vanceb/ESP32_Clock/README.md

# ESP32_Clock
Clock based on the ESP32

A follow-on from the NightClock
