vanceb/ESP32_Clock/kicad/inkscape_dxf_export_options.png

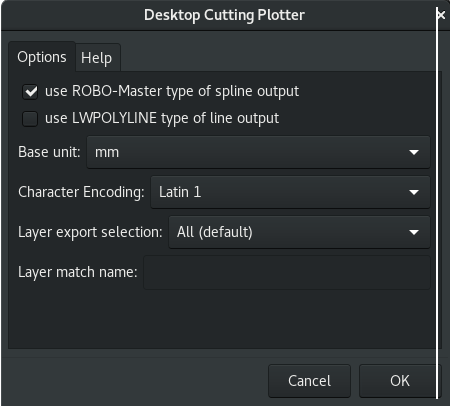
kicad/inkscape_dxf_export_options.png
