vanceb/ESP32_Clock/kicad/kicad_svg_export.png

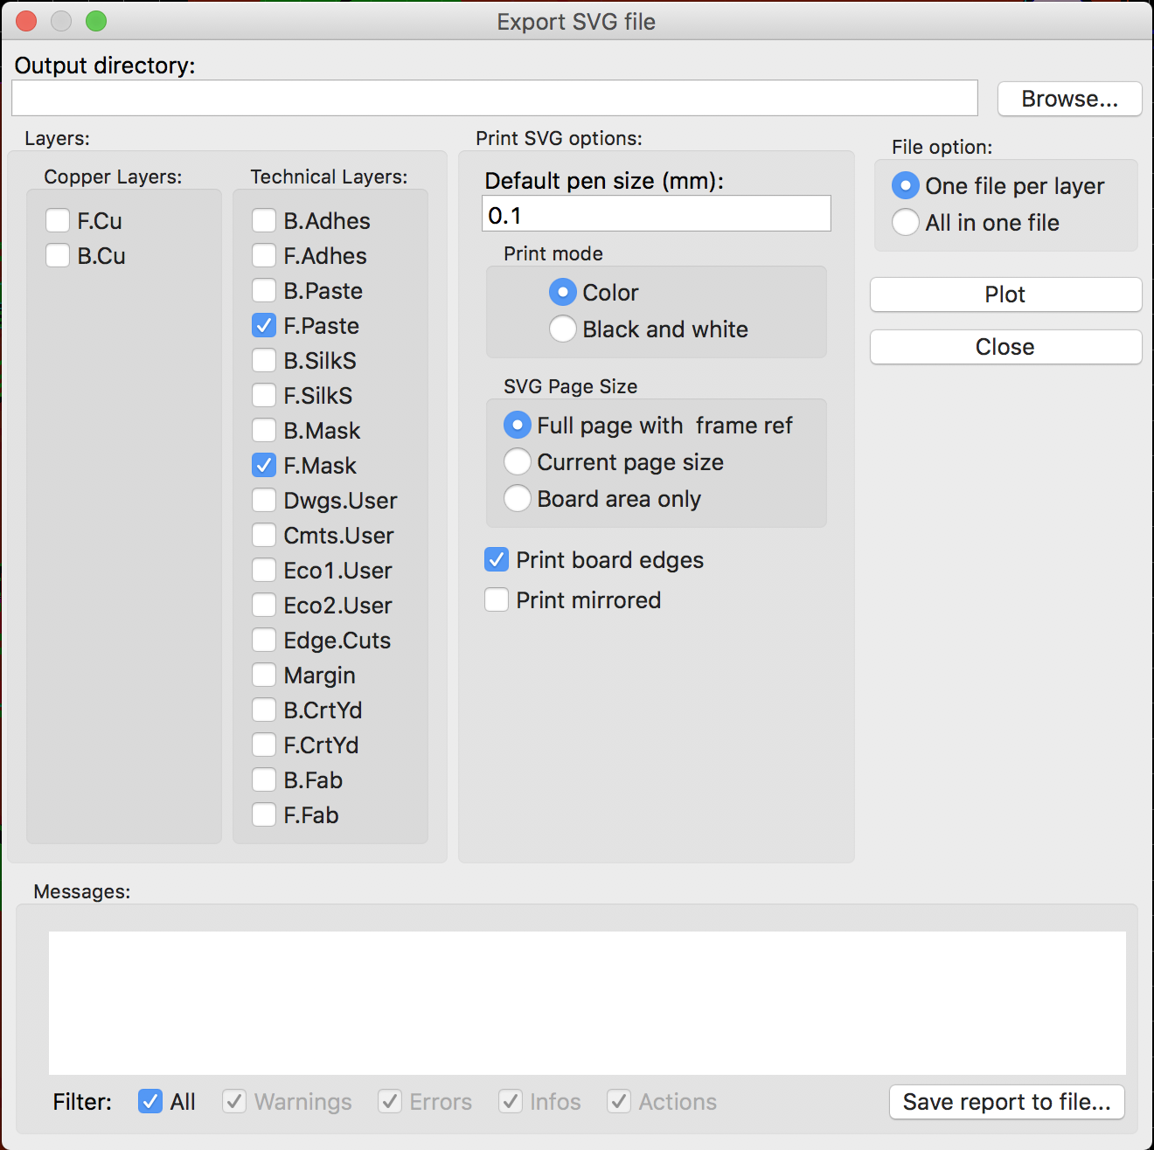
kicad/kicad_svg_export.png
