vanceb/ESP32_Clock/kicad/RDWorks.png

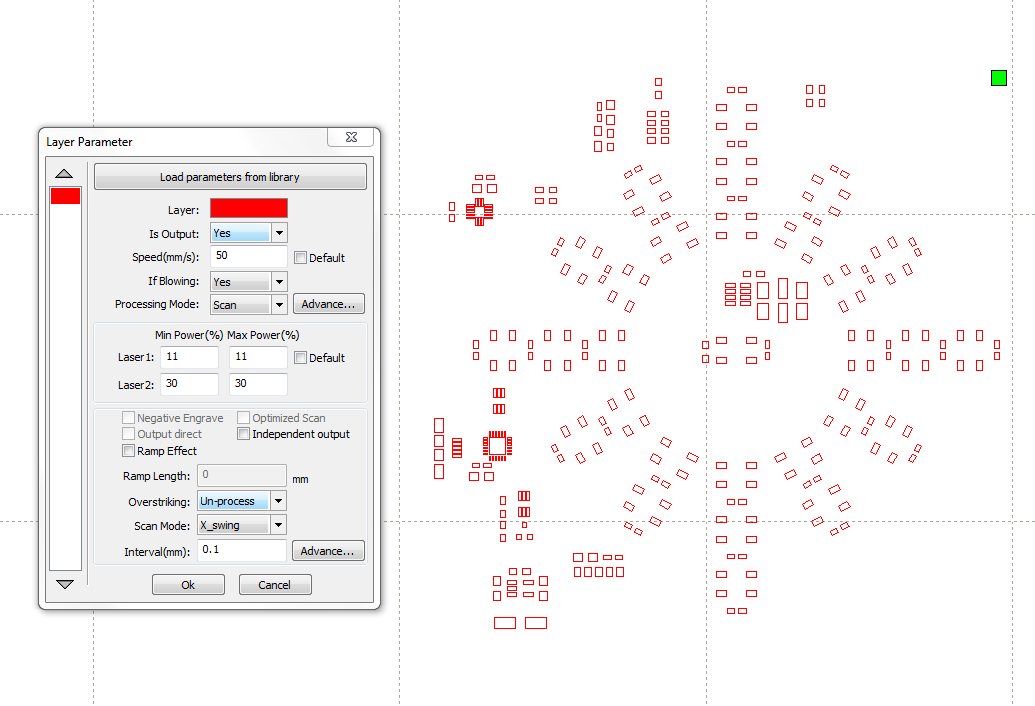
kicad/RDWorks.png
