vanceb/ESP32_Clock/code/components/wifi_manager/README

This component has been copied from https://github.com/tonyp7/esp32-wifi-manager
Changes have been made to integrate it with my project.
