vanceb/ESP32_Clock/kicad/ESP32_Clock_V2_BOM.ods

ESP32 Clock V2.0 BOM
Item | Qty | Reference(s) | Value
1 | 2 | C1, C8 | 100nF
2 | 2 | C2, C7 | 10uF
3 | 1 | C3 | CP
4 | 2 | C4, C5 | 4.7uF
5 | 1 | C6 | 1uF
6 | 29 | C9, C10, C11, C12, C13, C14, C15, C16, C17, C18, C19, C20, C21, C22, C23, C24, C25, C26, C27, C28, C29, C30, C31, C32, C33, C34, C35, C36, C37 | 0.1uF
7 | 2 | C38, C40 | 1uF
8 | 1 | C39 | 47uF
9 | 1 | D1
10 | 2 | D2, D3 | LED
11 | 1 | J1 | Pwr
12 | 1 | J2 | Battery
13 | 1 | J3 | FTDI
14 | 1 | J4 | LEDs
15 | 1 | J9 | Gesture
16 | 1 | J10 | OLED
17 | 1 | J11 | MMA8542Q Accelerometer
18 | 1 | R1 | 2k
19 | 8 | R2, R3, R4, R5, R11, R12, R14, R15 | 4k7
20 | 3 | R6, R10, R16 | 10k
21 | 2 | R7, R8 | 1k
22 | 1 | R9 | 100R
23 | 1 | R13 | 22R
24 | 1 | SW1 | Reset
25 | 1 | SW2 | Program
26 | 1 | U1 | MCP73831
27 | 1 | U2 | BA33DD0WHFP
28 | 1 | U3 | ESP32-WROOM
29 | 29 | U4, U5, U6, U7, U8, U9, U10, U11, U12, U13, U14, U15, U16, U17, U18, U19, U20, U21, U22, U23, U24, U25, U26, U27, U28, U29, U30, U31, U32 | WS2812B
30 | 1 | U33 | APDS-9960
