vanceb/ESP32_Clock/kicad/bom.ods

Collated Components:
Item | Qty | Reference(s) | Value | Footprint
1 | 3 | C1, C2, C42 | 4.7uF | Capacitors_SMD:C_0805_HandSoldering
2 | 1 | C3 | 1uF | Capacitors_SMD:C_0805_HandSoldering
3 | 3 | C4, C7, C9 | 100nF | Capacitors_SMD:C_0603_HandSoldering
4 | 3 | C5, C6, C8 | 10uF | Capacitors_SMD:C_0805_HandSoldering
5 | 31 | C10, C11, C12, C13, C14, C15, C16, C17, C18, C19, C20, C21, C22, C23, C24, C25, C26, C27, C28, C29, C30, C31, C32, C33, C34, C35, C36, C37, C38, C43, C44 | 0.1uF | Capacitors_SMD:C_0603_HandSoldering
6 | 2 | C39, C41 | 1uF | Capacitors_Tantalum_SMD:CP_Tantalum_Case-R_EIA-2012-12_Hand
7 | 1 | C40 | 47uF | Capacitors_Tantalum_SMD:CP_Tantalum_Case-A_EIA-3216-18_Hand
8 | 1 | C45 | CP | Capacitors_THT:CP_Radial_D8.0mm_P3.50mm
9 | 2 | D1, D2 | LED | LEDs:LED_0603_HandSoldering
10 | 1 | D3 |  | Diodes_SMD:D_SMA_Handsoldering
11 | 1 | J1 | Battery | Connectors_JST:JST_PH_S2B-PH-K_02x2.00mm_Angled
12 | 1 | J2 | LEDs | Pin_Headers:Pin_Header_Straight_1x03_Pitch2.54mm
13 | 1 | J3 | PWR | Pin_Headers:Pin_Header_Straight_1x04_Pitch2.54mm
14 | 1 | J4 | Grove 1 | Pin_Headers:Pin_Header_Straight_1x04_Pitch2.54mm
15 | 1 | J5 | Grove 2 | Pin_Headers:Pin_Header_Straight_1x04_Pitch2.54mm
16 | 1 | J6 | Grove 3 | Pin_Headers:Pin_Header_Straight_1x04_Pitch2.54mm
17 | 1 | J7 | Grove 4 | Pin_Headers:Pin_Header_Straight_1x04_Pitch2.54mm
18 | 1 | J8 | USB_OTG | MicroUSB_Custom:MicroUSB
19 | 1 | J9 | Gesture | Pin_Headers:Pin_Header_Straight_1x05_Pitch2.54mm
20 | 1 | J10 | OLED | 128x32_OLED:128x32_OLED
21 | 1 | J12 | FTDI | Pin_Headers:Pin_Header_Straight_1x06_Pitch2.54mm
22 | 1 | Q1 | NXP2301P | TO_SOT_Packages_SMD:SOT-23
23 | 1 | Q2 | BCM857 | TO_SOT_Packages_SMD:SOT-363_SC-70-6_Handsoldering
24 | 1 | Q3 | UMH3N | TO_SOT_Packages_SMD:SOT-363_SC-70-6_Handsoldering
25 | 3 | R1, R3, R11 | 10k | Resistors_SMD:R_0603_HandSoldering
26 | 1 | R2 | 2k | Resistors_SMD:R_0603_HandSoldering
27 | 1 | R4 | 47k | Resistors_SMD:R_0603_HandSoldering
28 | 8 | R5, R6, R7, R8, R12, R13, R15, R16 | 4k7 | Resistors_SMD:R_0603_HandSoldering
29 | 2 | R9, R10 | 1k | Resistors_SMD:R_0603_HandSoldering
30 | 1 | R14 | 22R | Resistors_SMD:R_0603_HandSoldering
31 | 1 | R17 | 100R | Resistors_SMD:R_0603_HandSoldering
32 | 1 | SW1 | Reset | Buttons_Switches_SMD:SW_SPST_EVPBF
33 | 1 | SW2 | Program | Buttons_Switches_SMD:SW_SPST_EVPBF
34 | 1 | U1 | MCP73831 | TO_SOT_Packages_SMD:SOT-23-5_HandSoldering
35 | 1 | U2 | ESP32-WROOM | ESP32-footprints-Lib:ESP32-WROOM
36 | 1 | U3 | BA33DD0WHFP | LDO:LDO
37 | 1 | U4 | CP2104 | QFN-24:QFN-24
38 | 29 | U5, U6, U7, U8, U9, U10, U11, U12, U13, U14, U15, U16, U17, U18, U19, U20, U21, U22, U23, U24, U25, U26, U27, U28, U29, U30, U31, U32, U33 | WS2812B | LEDs:LED_WS2812B-PLCC4
39 | 1 | U34 | APDS-9960 | ADPS-9960:ADPS-9960
40 | 1 | U35 | MMA8452Q | QFN16:QFN-16
