vanceb/ESP32_Clock/kicad/ESP32_Clock.kicad_pcb

## KiCad design kicad/ESP32_Clock.kicad_pcb (2018-07-30)

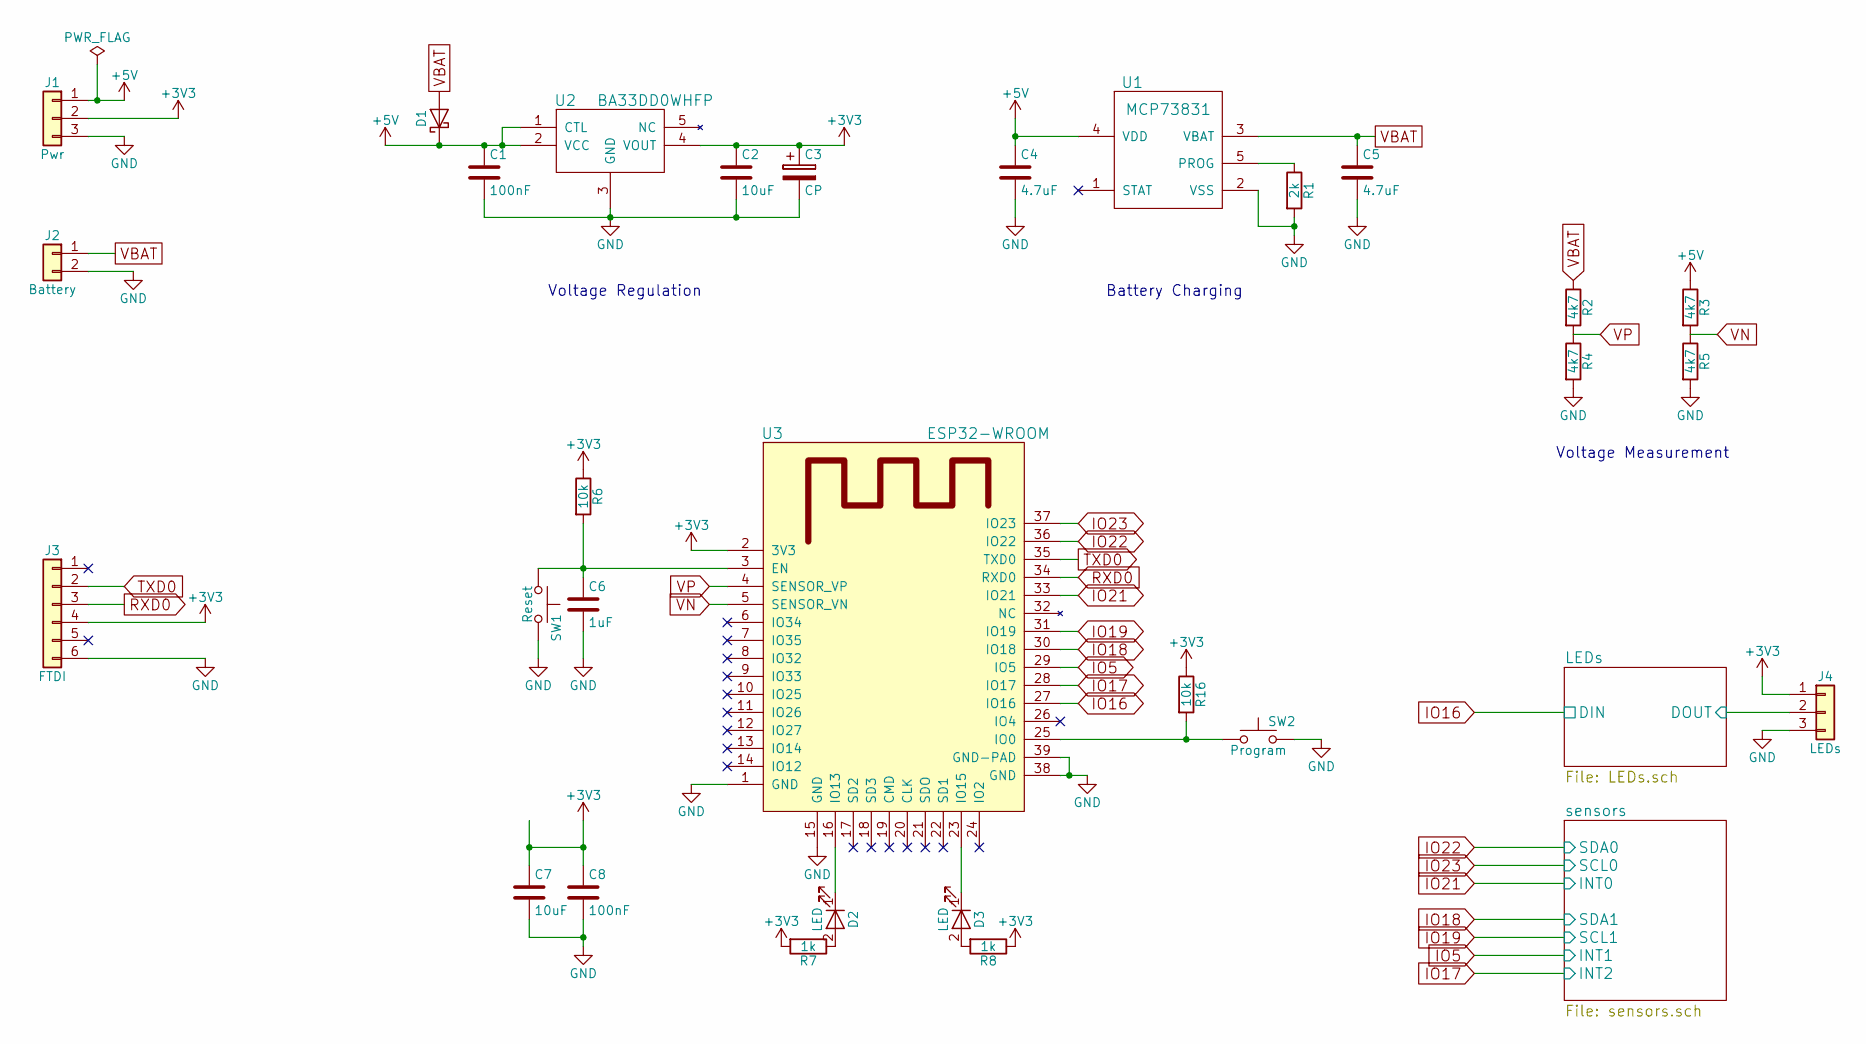
[picture p4: schematic ESP32_Clock-2018-08-15-16-18-59.sch]

Parts:
C1, C8: 100nF; C_0603_HandSoldering
C2, C7: 10uF; C_0805_HandSoldering
C3: CP; CP_Radial_D8.0mm_P3.50mm
C4, C5: 4.7uF; C_0805_HandSoldering
C6: 1uF; C_0805_HandSoldering
D1: D_SMA_Handsoldering
D2, D3: LED; LED_0603_HandSoldering
J1: Pwr; Pin_Header_Straight_1x03_Pitch2.54mm
J2: Battery; JST_PH_S2B-PH-K_02x2.00mm_Angled
J3: FTDI; Pin_Header_Straight_1x06_Pitch2.54mm
J4: LEDs; Pin_Header_Straight_1x03_Pitch2.54mm
R1: 2k; R_0603_HandSoldering
R2, R3, R4, R5: 4k7; R_0603_HandSoldering
R6, R16: 10k; R_0603_HandSoldering
R7, R8: 1k; R_0603_HandSoldering
SW1: Reset; SW_SPST_EVPBF
SW2: Program; SW_SPST_EVPBF
U1: MCP73831; SOT-23-5_HandSoldering
U2: BA33DD0WHFP; LDO
U3: ESP32-WROOM

Connections:
+3V3: C2.1, C3.1, C7.1, C8.1, J1.2, J3.4, J4.1, R6.1, R7.2, R8.1, R16.1, U2.4 (VOUT), U3.2 (3V3); also elsewhere on the board
+5V: C1.1, C4.1, D1.1 (K), J1.1, R3.1, U1.4 (VDD), U2.1 (CTL), U2.2 (VCC)
/LEDs/DOUT: J4.2; also elsewhere on the board
GND: C1.2, C2.2, C3.2, C4.2, C5.2, C6.2, C7.2, C8.2, J1.3, J2.2, J3.6, J4.3, R1.2, R4.2, R5.2, SW1.2, SW2.2, U1.2 (VSS), U2.3 (GND), U3.1 (GND), U3.15 (GND), U3.38 (GND), U3.39 (GND-PAD); also elsewhere on the board
IO5: U3.29 (IO5); also elsewhere on the board
IO16: U3.27 (IO16); also elsewhere on the board
IO17: U3.28 (IO17); also elsewhere on the board
IO18: U3.30 (IO18); also elsewhere on the board
IO19: U3.31 (IO19); also elsewhere on the board
IO21: U3.33 (IO21); also elsewhere on the board
IO22: U3.36 (IO22); also elsewhere on the board
IO23: U3.37 (IO23); also elsewhere on the board
unnamed: C6.1, R6.2, SW1.1, U3.3 (EN)
unnamed: D2.1 (K), U3.16 (IO13)
unnamed: D2.2 (A), R7.1
unnamed: D3.1 (K), U3.23 (IO15)
unnamed: D3.2 (A), R8.2
unnamed: R1.1, U1.5 (PROG)
unnamed: R16.2, SW2.1, U3.25 (IO0)
RXD0: J3.3, U3.34 (RXD0)
TXD0: J3.2, U3.35 (TXD0)
VBAT: C5.1, D1.2 (A), J2.1, R2.1, U1.3 (VBAT)
VN: R3.2, R5.1, U3.5 (SENSOR_VN)
VP: R2.2, R4.1, U3.4 (SENSOR_VP)

Notes on the sheet:
Voltage Regulation
Battery Charging
Voltage Measurement

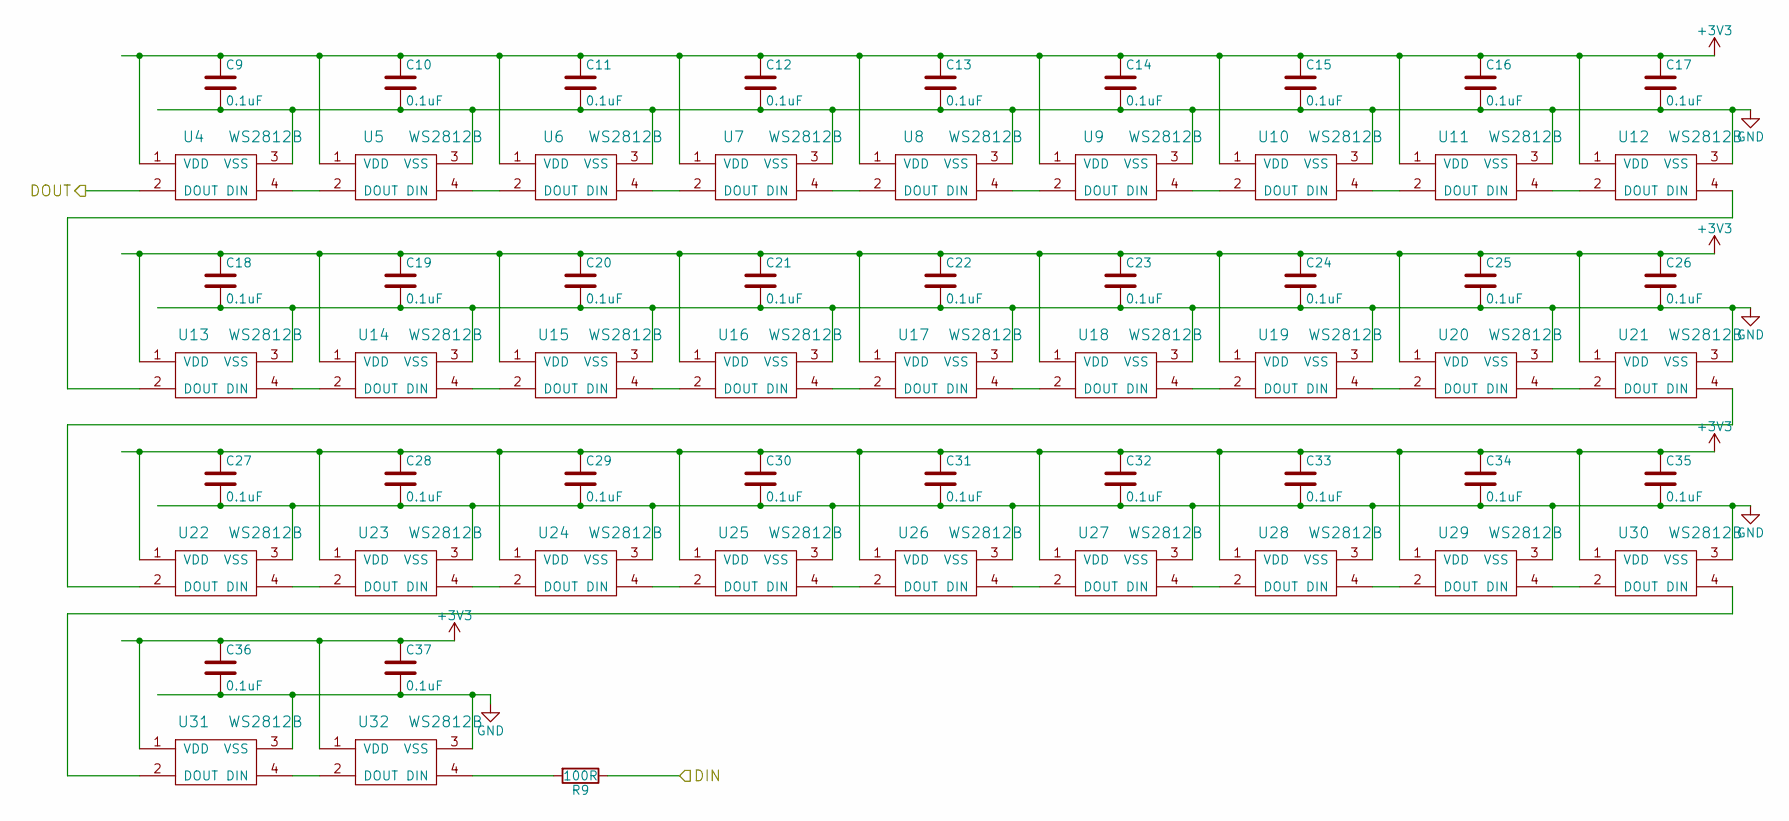
[picture p5: schematic LEDs-2018-08-15-16-18-59.sch]

Parts:
C9, C10, C11, C12, C13, C14, C15, C16, C17, C18, C19, C20, C21, C22, C23, C24, C25, C26, C27, C28, C29, C30, C31, C32, C33, C34, C35, C36, C37: 0.1uF; C_0603_HandSoldering
R9: 100R; R_0603_HandSoldering
U4, U5, U6, U7, U8, U9, U10, U11, U12, U13, U14, U15, U16, U17, U18, U19, U20, U21, U22, U23, U24, U25, U26, U27, U28, U29, U30, U31, U32: WS2812B; LED_WS2812B-PLCC4

Connections:
+3V3: C9.1, C10.1, C11.1, C12.1, C13.1, C14.1, C15.1, C16.1, C17.1, C18.1, C19.1, C20.1, C21.1, C22.1, C23.1, C24.1, C25.1, C26.1, C27.1, C28.1, C29.1, C30.1, C31.1, C32.1, C33.1, C34.1, C35.1, C36.1, C37.1, U4.1 (VDD), U5.1 (VDD), U6.1 (VDD), U7.1 (VDD), U8.1 (VDD), U9.1 (VDD), U10.1 (VDD), U11.1 (VDD), U12.1 (VDD), U13.1 (VDD), U14.1 (VDD), U15.1 (VDD), U16.1 (VDD), U17.1 (VDD), U18.1 (VDD), U19.1 (VDD), U20.1 (VDD), U21.1 (VDD), U22.1 (VDD), U23.1 (VDD), U24.1 (VDD), U25.1 (VDD), U26.1 (VDD), U27.1 (VDD), U28.1 (VDD), U29.1 (VDD), U30.1 (VDD), U31.1 (VDD), U32.1 (VDD); also elsewhere on the board
/LEDs/DOUT: U4.2 (DOUT); also elsewhere on the board
GND: C9.2, C10.2, C11.2, C12.2, C13.2, C14.2, C15.2, C16.2, C17.2, C18.2, C19.2, C20.2, C21.2, C22.2, C23.2, C24.2, C25.2, C26.2, C27.2, C28.2, C29.2, C30.2, C31.2, C32.2, C33.2, C34.2, C35.2, C36.2, C37.2, U4.3 (VSS), U5.3 (VSS), U6.3 (VSS), U7.3 (VSS), U8.3 (VSS), U9.3 (VSS), U10.3 (VSS), U11.3 (VSS), U12.3 (VSS), U13.3 (VSS), U14.3 (VSS), U15.3 (VSS), U16.3 (VSS), U17.3 (VSS), U18.3 (VSS), U19.3 (VSS), U20.3 (VSS), U21.3 (VSS), U22.3 (VSS), U23.3 (VSS), U24.3 (VSS), U25.3 (VSS), U26.3 (VSS), U27.3 (VSS), U28.3 (VSS), U29.3 (VSS), U30.3 (VSS), U31.3 (VSS), U32.3 (VSS); also elsewhere on the board
IO16: R9.1; also elsewhere on the board
unnamed: R9.2, U32.4 (DIN)
unnamed: U4.4 (DIN), U5.2 (DOUT)
unnamed: U5.4 (DIN), U6.2 (DOUT)
unnamed: U6.4 (DIN), U7.2 (DOUT)
unnamed: U7.4 (DIN), U8.2 (DOUT)
unnamed: U8.4 (DIN), U9.2 (DOUT)
unnamed: U9.4 (DIN), U10.2 (DOUT)
unnamed: U10.4 (DIN), U11.2 (DOUT)
unnamed: U11.4 (DIN), U12.2 (DOUT)
unnamed: U12.4 (DIN), U13.2 (DOUT)
unnamed: U13.4 (DIN), U14.2 (DOUT)
unnamed: U14.4 (DIN), U15.2 (DOUT)
unnamed: U15.4 (DIN), U16.2 (DOUT)
unnamed: U16.4 (DIN), U17.2 (DOUT)
unnamed: U17.4 (DIN), U18.2 (DOUT)
unnamed: U18.4 (DIN), U19.2 (DOUT)
unnamed: U19.4 (DIN), U20.2 (DOUT)
unnamed: U20.4 (DIN), U21.2 (DOUT)
unnamed: U21.4 (DIN), U22.2 (DOUT)
unnamed: U22.4 (DIN), U23.2 (DOUT)
unnamed: U23.4 (DIN), U24.2 (DOUT)
unnamed: U24.4 (DIN), U25.2 (DOUT)
unnamed: U25.4 (DIN), U26.2 (DOUT)
unnamed: U26.4 (DIN), U27.2 (DOUT)
unnamed: U27.4 (DIN), U28.2 (DOUT)
unnamed: U28.4 (DIN), U29.2 (DOUT)
unnamed: U29.4 (DIN), U30.2 (DOUT)
unnamed: U30.4 (DIN), U31.2 (DOUT)
unnamed: U31.4 (DIN), U32.2 (DOUT)

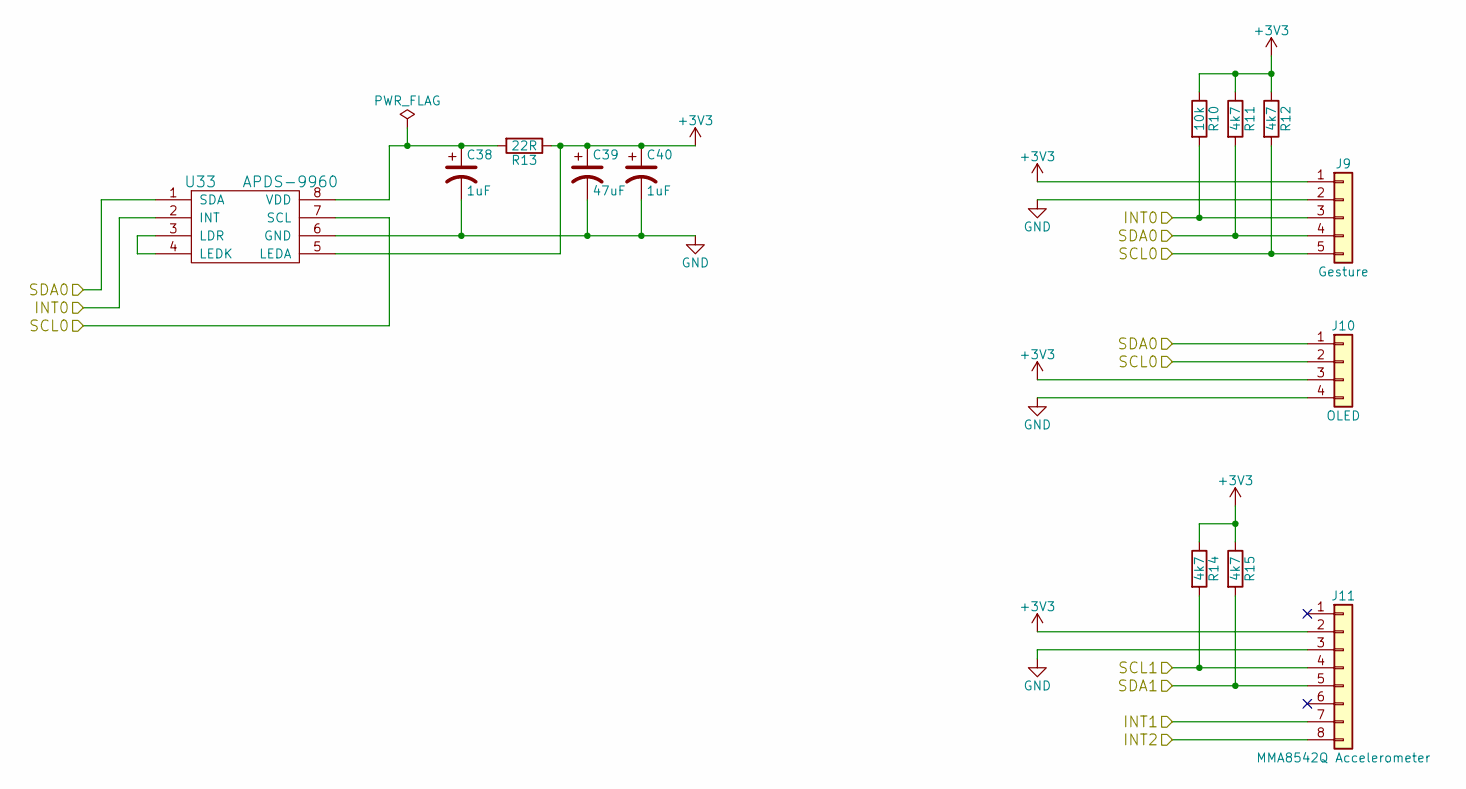
[picture p6: schematic sensors-2018-08-15-16-18-59.sch]

Parts:
C38, C40: 1uF; CP_Tantalum_Case-R_EIA-2012-12_Hand
C39: 47uF; CP_Tantalum_Case-A_EIA-3216-18_Hand
J9: Gesture; Pin_Header_Straight_1x05_Pitch2.54mm
J10: OLED; 128x32_OLED
J11: MMA8542Q Accelerometer; Pin_Header_Straight_1x08_Pitch2.54mm
R10: 10k; R_0603_HandSoldering
R11, R12, R14, R15: 4k7; R_0603_HandSoldering
R13: 22R; R_0603_HandSoldering
U33: APDS-9960; ADPS-9960

Connections:
+3V3: C39.1, C40.1, J9.1, J10.3, J11.2, R10.1, R11.1, R12.1, R13.1, R14.1, R15.1, U33.5 (LEDA); also elsewhere on the board
GND: C38.2, C39.2, C40.2, J9.2, J10.4, J11.3, U33.6 (GND); also elsewhere on the board
IO5: J11.7; also elsewhere on the board
IO17: J11.8; also elsewhere on the board
IO18: J11.5, R15.2; also elsewhere on the board
IO19: J11.4, R14.2; also elsewhere on the board
IO21: J9.3, R10.2, U33.2 (INT); also elsewhere on the board
IO22: J9.4, J10.1, R11.2, U33.1 (SDA); also elsewhere on the board
IO23: J9.5, J10.2, R12.2, U33.7 (SCL); also elsewhere on the board
unnamed: C38.1, R13.2, U33.8 (VDD)
unnamed: U33.3 (LDR), U33.4 (LEDK)

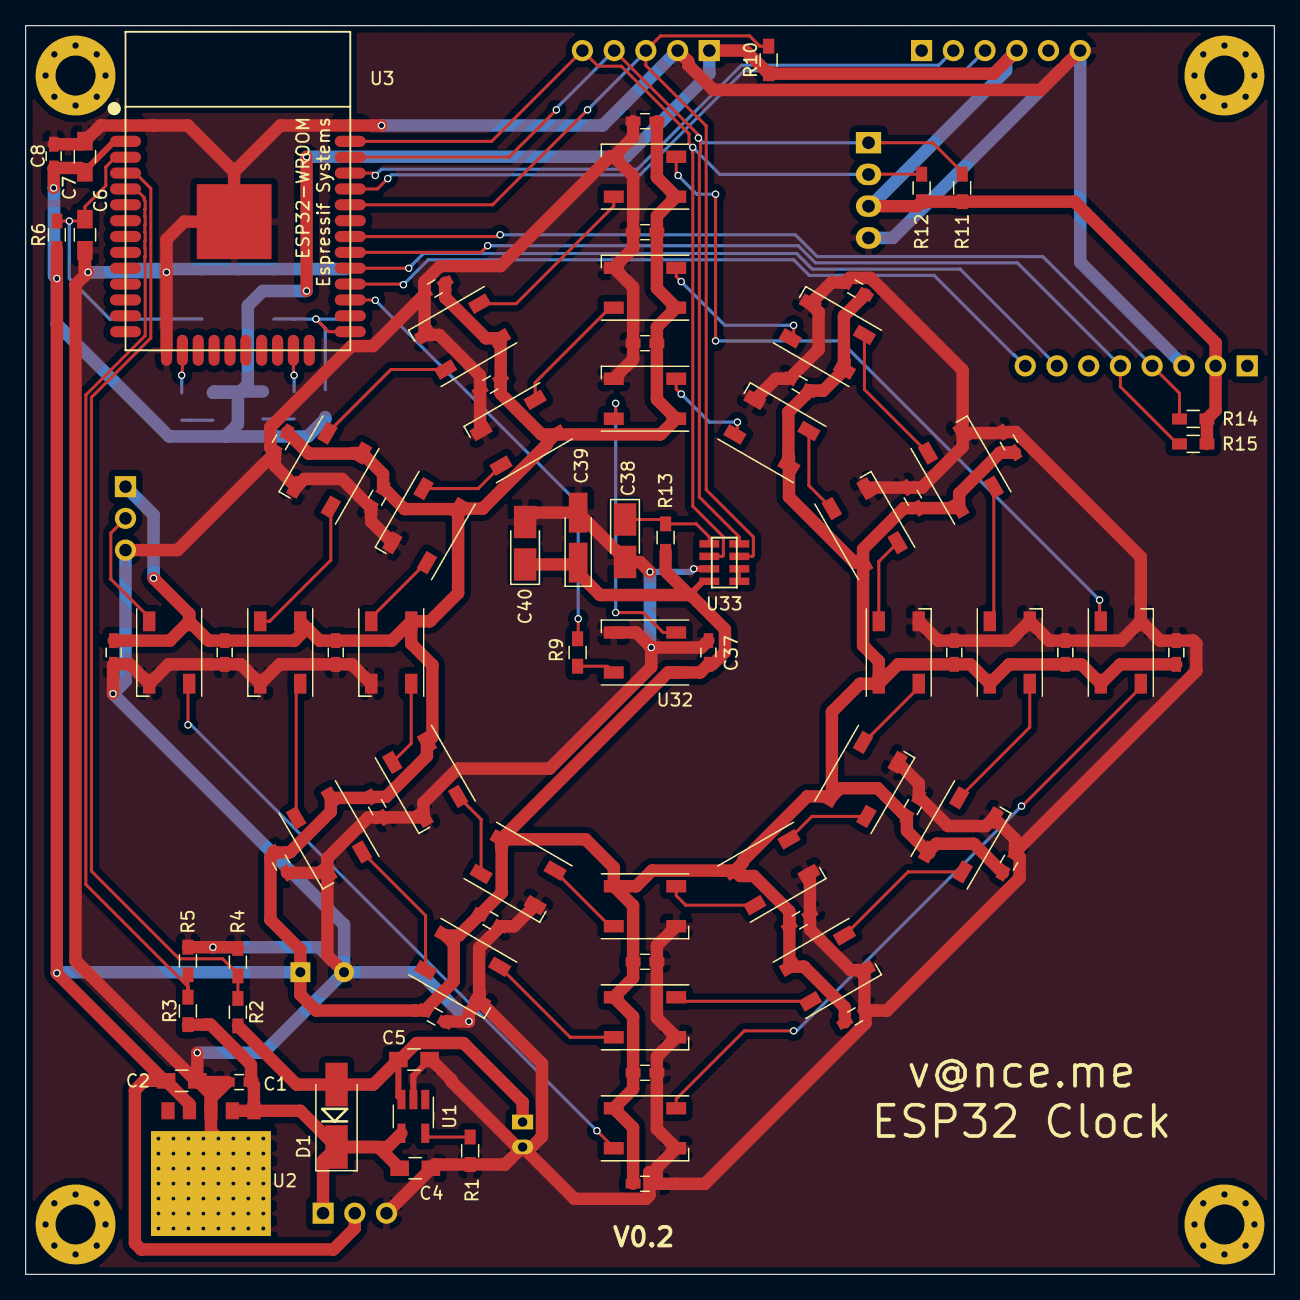
[picture p7: board ESP32_Clock.kicad_pcb from above]

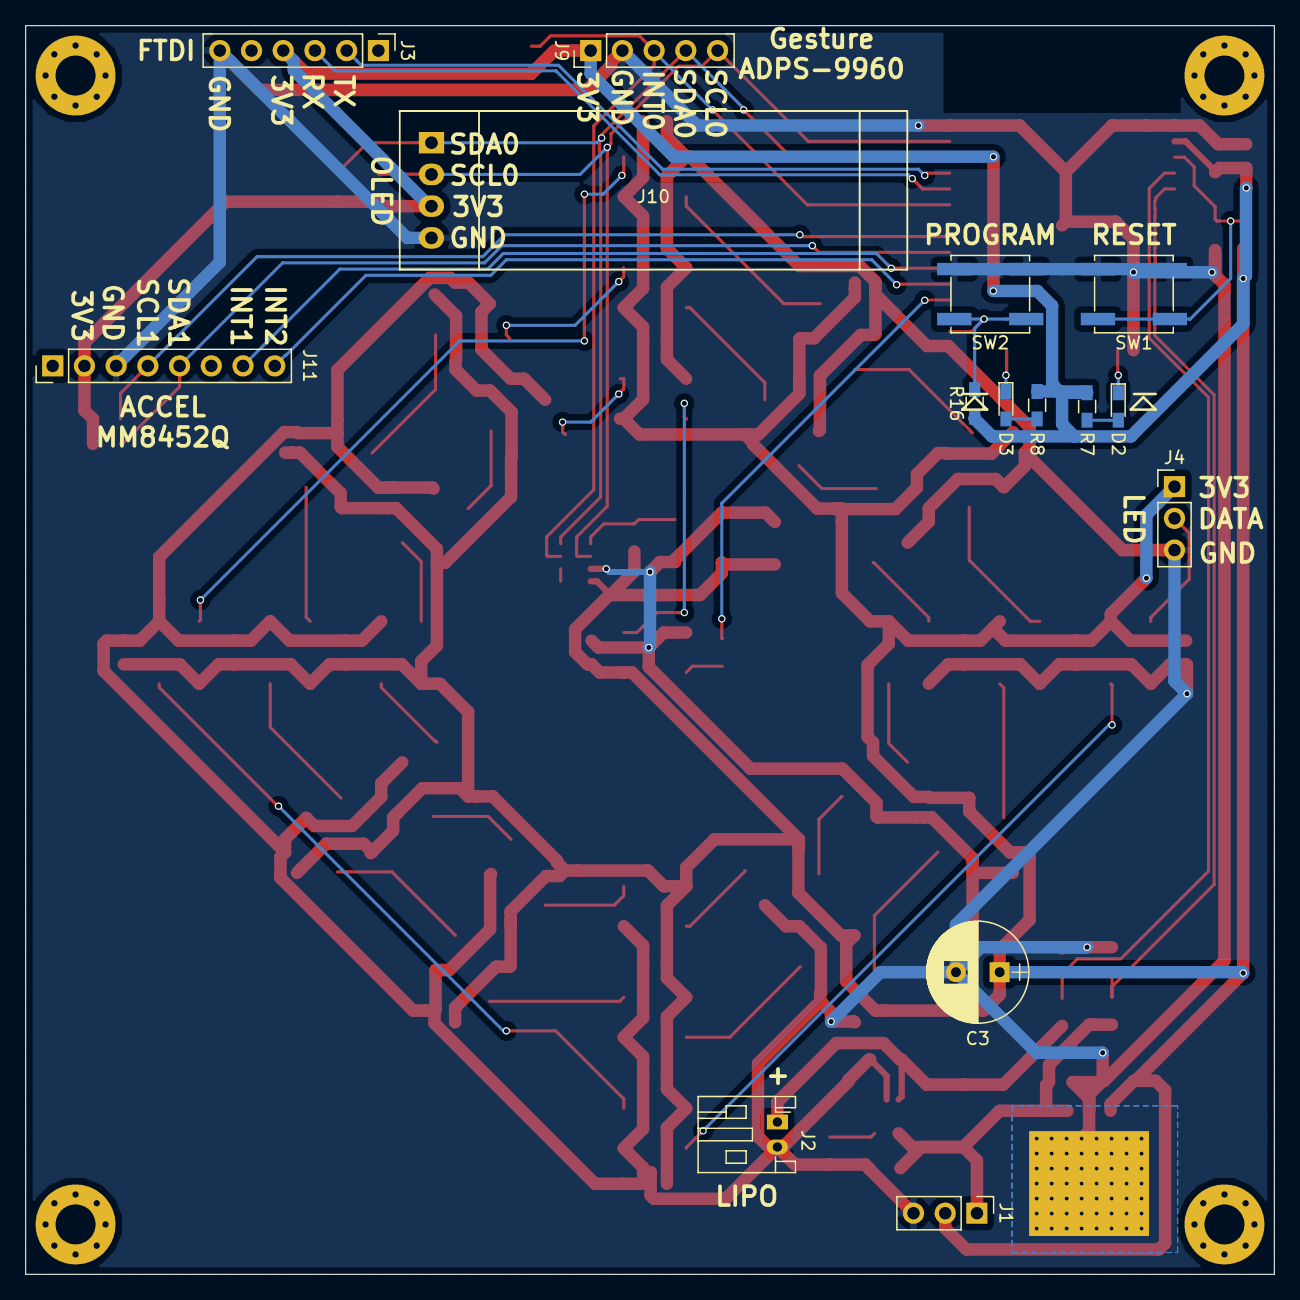
[picture p8: board ESP32_Clock.kicad_pcb from below]

Board: 2 copper layers, 100.0 x 100.0 mm, 101 parts (15 on the bottom side), 55 nets.
