vanceb/ESP32_Clock/code/main/main.c

/*
 * Copyright 2010-2015 Amazon.com, Inc. or its affiliates. All Rights Reserved.
 * Additions Copyright 2016 Espressif Systems (Shanghai) PTE LTD
 *
 * Licensed under the Apache License, Version 2.0 (the "License").
 * You may not use this file except in compliance with the License.
 * A copy of the License is located at
 *
 *  http://aws.amazon.com/apache2.0
 *
 * or in the "license" file accompanying this file. This file is distributed
 * on an "AS IS" BASIS, WITHOUT WARRANTIES OR CONDITIONS OF ANY KIND, either
 * express or implied. See the License for the specific language governing
 * permissions and limitations under the License.
 */
/**
 * @file subscribe_publish_sample.c
 * @brief simple MQTT publish and subscribe on the same topic
 *
 * This example takes the parameters from the build configuration and establishes a connection to the AWS IoT MQTT Platform.
 * It subscribes and publishes to the same topic - "test_topic/esp32"
 *
 * Some setup is required. See example README for details.
 *
 */
#include <stdio.h>
#include <stdlib.h>
#include <ctype.h>
#include <unistd.h>
#include <limits.h>
#include <string.h>
#include <math.h>

#include <time.h>
#include <sys/time.h>
#include "lwip/apps/sntp.h"

#include "freertos/FreeRTOS.h"
#include "freertos/task.h"
#include "freertos/event_groups.h"
#include "esp_system.h"
#include "esp_wifi.h"
#include "esp_event_loop.h"
#include "esp_log.h"
#include "esp_vfs_fat.h"
#include "driver/sdmmc_host.h"
#include "driver/gpio.h"
#include "driver/i2c.h"

#include "nvs.h"
#include "nvs_flash.h"

/* Needed for wifimanager */
#include "http_svr.h"
#include "wifi_manager.h"

// Project local code
#include "main.h"
//#include "clock_control.h"
#include "telemetry.h"
#include "clock_display.h"
#include "gesture.h"

#include "secrets.h"

static const char *TAG = "esp32clock";

static TaskHandle_t task_http_server = NULL;
static TaskHandle_t task_wifi_manager = NULL;

// Arduino-like functions to ease readability
uint32_t IRAM_ATTR millis()
{
  return xTaskGetTickCount() * portTICK_PERIOD_MS;
}

void delay(uint32_t ms)
{
  if (ms > 0) {
    vTaskDelay(ms / portTICK_PERIOD_MS);
  }
}

void i2cscanner(int sda_pin, int scl_pin) {
    static char tag[] = "i2cscanner";
	ESP_LOGD(tag, ">> i2cScanner");
    /* Set pins as outputs */
    if (i2c_set_pin(I2C_NUM_0, sda_pin, scl_pin, GPIO_PULLUP_DISABLE, GPIO_PULLUP_DISABLE, I2C_MODE_MASTER) != ESP_OK) {
        ESP_LOGE(TAG, "I2C GPIO pin configuration error");
    }

    /* Set up I2C configuration */
	i2c_config_t conf;
	conf.mode = I2C_MODE_MASTER;
	conf.sda_io_num = sda_pin;
	conf.scl_io_num = scl_pin;
	conf.sda_pullup_en = GPIO_PULLUP_DISABLE;
	conf.scl_pullup_en = GPIO_PULLUP_DISABLE;
	conf.master.clk_speed = 100000;
    /* Set configuration */
	if (i2c_param_config(I2C_NUM_0, &conf) != ESP_OK) {
        ESP_LOGE(TAG, "I2C configuration failed");
    }
    /* Install I2C driver */
	if (i2c_driver_install(I2C_NUM_0, I2C_MODE_MASTER, 0, 0, 0) != ESP_OK) {
        ESP_LOGE(TAG, "I2C driver install failed");
    }

	int i;
	esp_err_t espRc;
	printf("     0  1  2  3  4  5  6  7  8  9  a  b  c  d  e  f\n");
	printf("00:         ");
	for (i=3; i< 0x78; i++) {
		i2c_cmd_handle_t cmd = i2c_cmd_link_create();
		i2c_master_start(cmd);
		i2c_master_write_byte(cmd, (i << 1) | I2C_MASTER_WRITE, 1 /* expect ack */);
		i2c_master_stop(cmd);

		espRc = i2c_master_cmd_begin(I2C_NUM_0, cmd, 10/portTICK_PERIOD_MS);
		if (i%16 == 0) {
			printf("\n%.2x:", i);
		}
		if (espRc == 0) {
			printf(" %.2x", i);
		} else {
			printf(" --");
		}
		//ESP_LOGD(tag, "i=%d, rc=%d (0x%x)", i, espRc, espRc);
		i2c_cmd_link_delete(cmd);
	}
	printf("\n");
}

static void initialize_sntp(void)
{
    ESP_LOGI(TAG, "Initializing SNTP");
    sntp_setoperatingmode(SNTP_OPMODE_POLL);
    sntp_setservername(0, "pool.ntp.org");
    sntp_init();
}

static void obtain_time(void)
{
    xEventGroupWaitBits(wifi_manager_event_group, WIFI_MANAGER_WIFI_CONNECTED_BIT,
                        false, true, portMAX_DELAY);
    initialize_sntp();

    // wait for time to be set
    time_t now = 0;
    struct tm timeinfo = { 0 };
    int retry = 0;
    const int retry_count = 10;
    while(timeinfo.tm_year < (2016 - 1900) && ++retry < retry_count) {
        ESP_LOGI(TAG, "Waiting for system time to be set... (%d/%d)", retry, retry_count);
        vTaskDelay(2000 / portTICK_PERIOD_MS);
        time(&now);
        localtime_r(&now, &timeinfo);
    }
}

// Initialise and run the tasks
void app_main()
{
    // Initialize NVS.
    esp_err_t err = nvs_flash_init();
    if (err == ESP_ERR_NVS_NO_FREE_PAGES) {
        ESP_ERROR_CHECK(nvs_flash_erase());
        err = nvs_flash_init();
    }
    ESP_ERROR_CHECK( err );

    /* Declare external variables used for communication */
    //int request_display_mode = 0;
    //rgb request_color = {0,0,0};

    /* Scan I2C */
    //i2cscanner(22, 23);

    // Setup wifi
    /* disable the default wifi logging */
	esp_log_level_set("wifi", ESP_LOG_NONE);

	/* start the HTTP Server task */
	xTaskCreate(&http_svr, "http_server", 2048, NULL, 5, &task_http_server);

	/* start the wifi manager task */
	xTaskCreate(&wifi_manager, "wifi_manager", 4096, NULL, 4, &task_wifi_manager);

    /* Telemetry task for MQTT communication */
    xTaskCreatePinnedToCore(&telemetry_task, "telemetry_task", 9216, NULL, 5, NULL, 1);

    /* Start the gesture and light sensor task */
    xTaskCreate(&gestureTask, "gesture", 4096, NULL, 5, NULL);

    /* Initialise the LED Strands */
    ledStrandSetup();
    xTaskCreate(&clock_display_task, "display_task", 3*configMINIMAL_STACK_SIZE, NULL, 5, NULL);



    /* Deal with the time */
    time_t now;
    struct tm timeinfo;
    time(&now);
    localtime_r(&now, &timeinfo);
    // Is time set? If not, tm_year will be (1970 - 1900).
    if (timeinfo.tm_year < (2016 - 1900)) {
        ESP_LOGI(TAG, "Time is not set yet. Connecting to WiFi and getting time over NTP.");
        obtain_time();
        // update 'now' variable with current time
        time(&now);
    }
    char strftime_buf[64];

    // Set timezone to UK Time and print local time
    setenv("TZ", "GMT0BST,M3.5.0/1,M10.5.0", 1);
    tzset();
    localtime_r(&now, &timeinfo);
    strftime(strftime_buf, sizeof(strftime_buf), "%c", &timeinfo);
    ESP_LOGI(TAG, "The current date/time in UK is: %s", strftime_buf);

    // Time is now set, so change display to clock mode 
    request_display_mode = 1;
}
