vanceb/ESP32_Clock/code/components/wifi_manager/include/wifi_manager.h

/*
Copyright (c) 2017 Tony Pottier

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
@file wifi_manager.h
@author Tony Pottier
@brief Defines all functions necessary for esp32 to connect to a wifi/scan wifis

Contains the freeRTOS task and all necessary support

@see https://idyl.io
@see https://github.com/tonyp7/esp32-wifi-manager
*/

#ifndef WIFI_MANAGER_H_INCLUDED
#define WIFI_MANAGER_H_INCLUDED


#ifdef __cplusplus
extern "C" {
#endif

/**
 * Extern variables to allow status of wifi to be used 
 */
extern EventGroupHandle_t wifi_manager_event_group;

/* @brief indicate that the ESP32 is currently connected. */
#define WIFI_MANAGER_WIFI_CONNECTED_BIT BIT0

#define WIFI_MANAGER_AP_STA_CONNECTED_BIT BIT1

/* @brief Set automatically once the SoftAP is started */
#define WIFI_MANAGER_AP_STARTED BIT2

/* @brief When set, means a client requested to connect to an access point.*/
#define WIFI_MANAGER_REQUEST_STA_CONNECT_BIT BIT3

/* @brief This bit is set automatically as soon as a connection was lost */
#define WIFI_MANAGER_STA_DISCONNECT_BIT BIT4

/* @brief When set, means a client requested to scan wireless networks. */
#define WIFI_MANAGER_REQUEST_WIFI_SCAN BIT5

/* @brief When set, means a client requested to disconnect from currently connected AP. */
#define WIFI_MANAGER_REQUEST_WIFI_DISCONNECT BIT6


/**
 * @brief If WIFI_MANAGER_DEBUG is defined, additional debug information will be sent to the standard output.
 */
#define WIFI_MANAGER_DEBUG	1

/**
 * @brief Defines the maximum size of a SSID name. 32 is IEEE standard.
 * @warning limit is also hard coded in wifi_config_t. Never extend this value.
 */
#define MAX_SSID_SIZE		32

/**
 * @brief Defines the maximum size of a WPA2 passkey. 64 is IEEE standard.
 * @warning limit is also hard coded in wifi_config_t. Never extend this value.
 */
#define MAX_PASSWORD_SIZE	64


/**
 * @brief Defines the maximum number of access points that can be scanned.
 *
 * To save memory and avoid nasty out of memory errors,
 * we can limit the number of APs detected in a wifi scan.
 */
#define MAX_AP_NUM 			15


/** @brief Defines the auth mode as an access point
 *  Value must be of type wifi_auth_mode_t
 *  @see esp_wifi_types.h
 */
#define AP_AUTHMODE 		WIFI_AUTH_WPA2_PSK

/** @brief Defines visibility of the access point. 0: visible AP. 1: hidden */
#define DEFAULT_AP_SSID_HIDDEN 		0

/** @brief Defines access point's name. */
#define DEFAULT_AP_SSID 			"esp32"

/** @brief Defines access point's password.
 *	@warning In the case of an open access point, the password must be a null string "" or "\0" if you want to be verbose but waste one byte.
 */
#define DEFAULT_AP_PASSWORD 		"esp32pwd"

/** @brief Defines access point's bandwidth.
 *  Value: WIFI_BW_HT20 for 20 MHz  or  WIFI_BW_HT40 for 40 MHz
 *  20 MHz minimize channel interference but is not suitable for
 *  applications with high data speeds
 */
#define DEFAULT_AP_BANDWIDTH 			WIFI_BW_HT20

/** @brief Defines access point's channel.
 *  Channel selection is only effective when not connected to another AP.
 *  Good practice for minimal channel interference to use
 *  For 20 MHz: 1, 6 or 11 in USA and 1, 5, 9 or 13 in most parts of the world
 *  For 40 MHz: 3 in USA and 3 or 11 in most parts of the world
 */
#define DEFAULT_AP_CHANNEL 			5

/** @brief Defines access point's maximum number of clients. */
#define AP_MAX_CONNECTIONS 	4

/** @brief Defines access point's beacon interval. 100ms is the recommended default. */
#define AP_BEACON_INTERVAL 	100

/** @brief Defines if esp32 shall run both AP + STA when connected to another AP.
 *  Value: 0 will have the own AP always on (APSTA mode)
 *  Value: 1 will turn off own AP when connected to another AP (STA only mode when connected)
 *  Turning off own AP when connected to another AP minimize channel interference and increase throughput
 */
#define DEFAULT_STA_ONLY 			1

/** @brief Defines if wifi power save shall be enabled.
 *  Value: WIFI_PS_NONE for full power (wifi modem always on)
 *  Value: WIFI_PS_MODEM for power save (wifi modem sleep periodically)
 *  Note: Power save is only effective when in STA only mode
 */
#define DEFAULT_STA_POWER_SAVE 			WIFI_PS_MODEM

/**
 * @brief Defines the maximum length in bytes of a JSON representation of an access point.
 *
 *  maximum ap string length with full 32 char ssid: 75 + \\n + \0 = 77\n
 *  example: {"ssid":"abcdefghijklmnopqrstuvwxyz012345","chan":12,"rssi":-100,"auth":4},\n
 *  BUT: we need to escape JSON. Imagine a ssid full of \" ? so it's 32 more bytes hence 77 + 32 = 99.\n
 *  this is an edge case but I don't think we should crash in a catastrophic manner just because
 *  someone decided to have a funny wifi name.
 */
#define JSON_ONE_APP_SIZE 99

/**
 * @brief Defines the maximum length in bytes of a JSON representation of the IP information
 * assuming all ips are 4*3 digits, and all characters in the ssid require to be escaped.
 * example: {"ssid":"abcdefghijklmnopqrstuvwxyz012345","ip":"192.168.1.119","netmask":"255.255.255.0","gw":"192.168.1.1","urc":0}
 */
#define JSON_IP_INFO_SIZE 150



typedef enum update_reason_code_t {
	UPDATE_CONNECTION_OK = 0,
	UPDATE_FAILED_ATTEMPT = 1,
	UPDATE_USER_DISCONNECT = 2,
	UPDATE_LOST_CONNECTION = 3
}update_reason_code_t;

/**
 * The actual WiFi settings in use
 */
struct wifi_settings_t{
	uint8_t ap_ssid[MAX_SSID_SIZE];
	uint8_t ap_pwd[MAX_PASSWORD_SIZE];
	uint8_t ap_channel;
	uint8_t ap_ssid_hidden;
	wifi_bandwidth_t ap_bandwidth;
	bool sta_only;
	wifi_ps_type_t sta_power_save;
	bool sta_static_ip;
	tcpip_adapter_ip_info_t sta_static_ip_config;
};
extern struct wifi_settings_t wifi_settings;


/**
 * Frees up all memory allocated by the wifi_manager and kill the task.
 */
void wifi_manager_destroy();

/**
 * Filters the AP scan list to unique SSIDs
 */
void filter_unique( wifi_ap_record_t * aplist, uint16_t * ap_num);

/**
 * Main task for the wifi_manager
 */
void wifi_manager( void * pvParameters );


char* wifi_manager_get_ap_list_json();
char* wifi_manager_get_ip_info_json();




/**
 * @brief saves the current STA wifi config to flash ram storage.
 */
esp_err_t wifi_manager_save_sta_config();

/**
 * @brief fetch a previously STA wifi config in the flash ram storage.
 * @return true if a previously saved config was found, false otherwise.
 */
bool wifi_manager_fetch_wifi_sta_config();

wifi_config_t* wifi_manager_get_wifi_sta_config();


/**
 * @brief A standard wifi event manager.
 * The following event are being monitoring and will set/clear group events:
 * SYSTEM_EVENT_AP_START
 * SYSTEM_EVENT_AP_STACONNECTED
 * SYSTEM_EVENT_AP_STADISCONNECTED
 * SYSTEM_EVENT_STA_START
 * SYSTEM_EVENT_STA_GOT_IP
 * SYSTEM_EVENT_STA_DISCONNECTED
 */
esp_err_t wifi_manager_event_handler(void *ctx, system_event_t *event);


/**
 * @brief requests a connection to an access point that will be process in the main task thread.
 */
void wifi_manager_connect_async();

/**
 * @brief requests a wifi scan
 */
void wifi_manager_scan_async();

/**
 * @brief requests to disconnect and forget about the access point.
 */
void wifi_manager_disconnect_async();

/**
 * @brief Tries to get access to json buffer mutex.
 *
 * The HTTP server can try to access the json to serve clients while the wifi manager thread can try
 * to update it. These two tasks are synchronized through a mutex.
 *
 * The mutex is used by both the access point list json and the connection status json.\n
 * These two resources should technically have their own mutex but we lose some flexibility to save
 * on memory.
 *
 * This is a simple wrapper around freeRTOS function xSemaphoreTake.
 *
 * @param xTicksToWait The time in ticks to wait for the semaphore to become available.
 * @return true in success, false otherwise.
 */
bool wifi_manager_lock_json_buffer(TickType_t xTicksToWait);

/**
 * @brief Releases the json buffer mutex.
 */
void wifi_manager_unlock_json_buffer();

/**
 * @brief Generates the connection status json: ssid and IP addresses.
 * @note This is not thread-safe and should be called only if wifi_manager_lock_json_buffer call is successful.
 */
void wifi_manager_generate_ip_info_json(update_reason_code_t update_reason_code);
/**
 * @brief Clears the connection status json.
 * @note This is not thread-safe and should be called only if wifi_manager_lock_json_buffer call is successful.
 */
void wifi_manager_clear_ip_info_json();

/**
 * @brief Generates the list of access points after a wifi scan.
 * @note This is not thread-safe and should be called only if wifi_manager_lock_json_buffer call is successful.
 */
void wifi_manager_generate_acess_points_json();

/**
 * @brief Clear the list of access points.
 * @note This is not thread-safe and should be called only if wifi_manager_lock_json_buffer call is successful.
 */
void wifi_manager_clear_access_points_json();

#ifdef __cplusplus
}
#endif

#endif /* WIFI_MANAGER_H_INCLUDED */
