vanceb/ESP32_Clock/(commit log)

2018-02-28 Initial kicad commit
    [ESP32_Clock.kicad_pcb, ESP32_Clock.sch]
2018-03-30 Board design almost ready for fabrication
    [ESP32_Clock.kicad_pcb, ESP32_Clock.sch, LEDs.sch, sensors.sch]
2018-04-09 PCB at v0.1, and some simple modifications to AWS IOT code using the esp-idf framework
    [ESP32_Clock-B.Cu.gbl, ESP32_Clock-B.Mask.gbs, ESP32_Clock-B.Paste.gbp, ESP32_Clock-B.SilkS.gbo, ESP32_Clock-Edge.Cuts.gm1, ESP32_Clock-F.Cu.gtl, ESP32_Clock-F.Mask.gts, ESP32_Clock-F.Paste.gtp]
2018-05-29 Initial changes after first board test
    [ESP32_Clock.kicad_pcb, bom.ods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]
2018-06-20 Updated hardware design and removed test idf-code
    [ESP32_Clock.kicad_pcb, ESP32_Clock.kicad_pcb.bak.kicad_pcb, ESP32_Clock.sch, LEDs.sch, sensors.sch]
2018-06-23 Added pullup to IO0 to be safe during boot
    [ESP32_Clock.kicad_pcb, ESP32_Clock.sch, LEDs.sch, sensors.sch]
2018-07-19 Version 0.2 of the board layout - submitted for manufacture
    [ESP32_Clock-B.Cu.gbl, ESP32_Clock-B.Mask.gbs, ESP32_Clock-B.Paste.gbp, ESP32_Clock-B.SilkS.gbo, ESP32_Clock-Edge.Cuts.gm1, ESP32_Clock-F.Cu.gtl, ESP32_Clock-F.Mask.gts, ESP32_Clock-F.Paste.gtp]
2018-07-30 Solder paste template cutting
    [ESP32_Clock.csv, ESP32_Clock.kicad_pcb, ESP32_Clock_V2_BOM.ods]
2018-09-09 Updated to kicad 5
    [ESP32_Clock-2018-08-15-16-18-59.sch, LEDs-2018-08-15-16-18-59.sch, sensors-2018-08-15-16-18-59.sch]
2018-09-24 Added correct subscribe task
    [telemetry.c]
2018-11-07 Updated telemetry to fixed size messages and implemented some basic actions for commands
    [telemetry.c, telemetry.h]
2018-11-07 Intermediate commit - still occasionally crashes whilst ssl encrypt/decrypt
    [main.c, telemetry.c, telemetry.h]
2018-11-07 Now doesn't crash randomly on mqtt receive
    [main.c, telemetry.c]
2018-11-07 Removed small memory leak and re-enabled mqtt echo of incoming commands
    [telemetry.c]
2018-11-28 Allowed ESP_ERR_WIFI_TIMEOUT as a result of a wifi scan without reboot
    [clock_display.c, main.c]
2018-12-18 BOM produced
    [ESP32_Clock.csv]
2019-03-22 Fixed clock overrun issue which stopped status updates after just over an hour
    [clock_display.c, main.h, telemetry.c, telemetry.h]
